WLaney/L3GD20H-gyro-PCB/gyro.brd

## EAGLE design gyro.brd (2016-07-08)

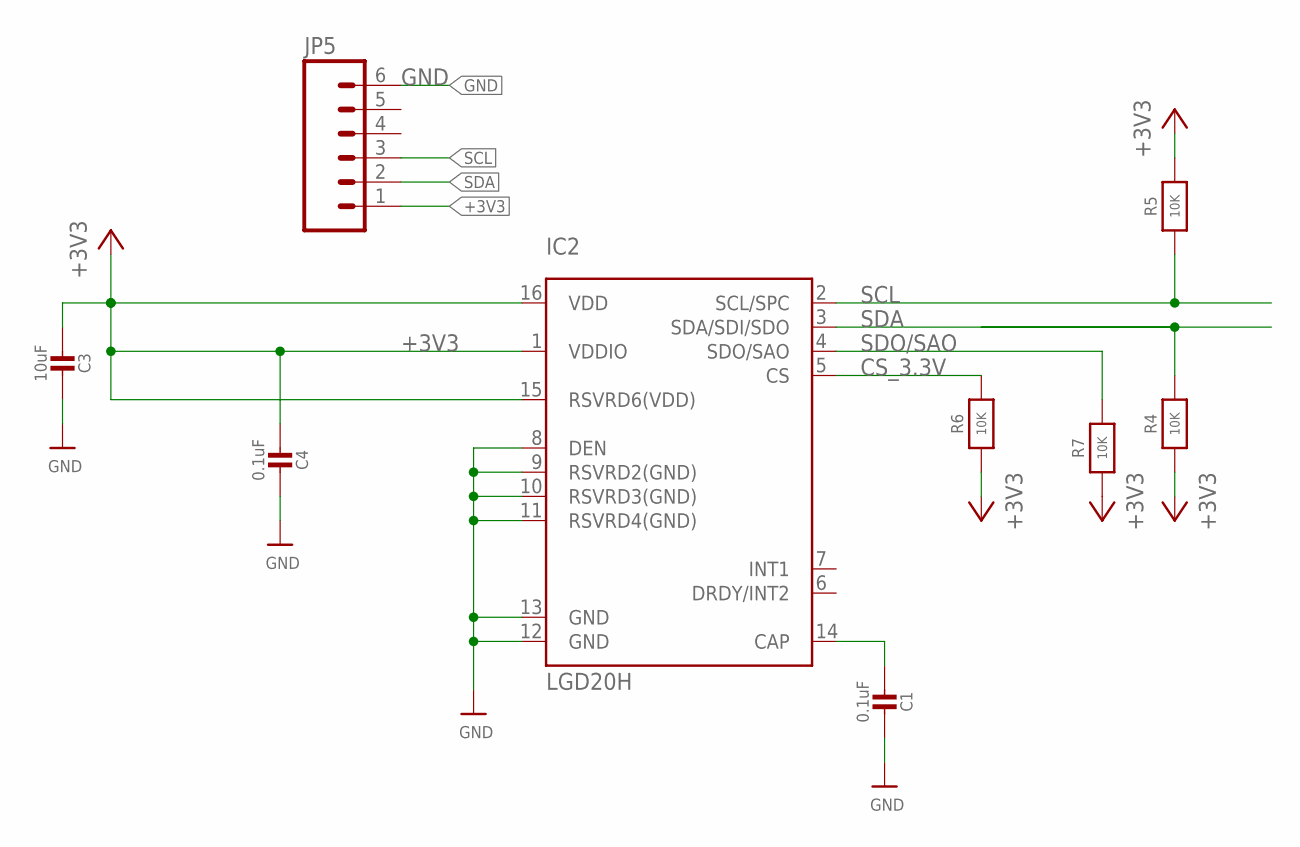
[picture p1: schematic gyro.sch]

Parts:
C1, C4: 0.1uF; 0805-NO
C3: 10uF; 0805-NO
IC2: LGD20H; L3GD20H_LGA16L
JP5: M06SIP; 1X06
R4, R5, R7: 10K; 0805-NO
R6: 10K; _0805MP

Connections:
+3V3: C3.2, C4.2, IC2.1 (VDDIO), IC2.15 (RSVRD6(VDD)), IC2.16 (VDD), JP5.1, R4.1, R5.2, R6.1, R7.1
CS_3.3V: IC2.5 (CS), R6.2
GND: C1.1, C3.1, C4.1, IC2.8 (DEN), IC2.9 (RSVRD2(GND)), IC2.10 (RSVRD3(GND)), IC2.11 (RSVRD4(GND)), IC2.12 (GND), IC2.13 (GND), JP5.6
unnamed: C1.2, IC2.14 (CAP)
SCL: IC2.2 (SCL/SPC), JP5.3, R5.1
SDA: IC2.3 (SDA/SDI/SDO), JP5.2, R4.2
SDO/SAO: IC2.4 (SDO/SAO), R7.2

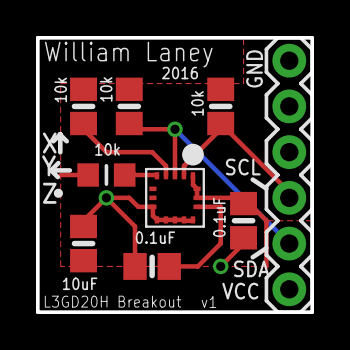
[picture p2: board gyro.brd from above]

Board: 2 copper layers, 15.2 x 15.2 mm, 9 parts (0 on the bottom side), 7 nets.
