WLaney/L3GD20H-gyro-PCB/(commit log)

2016-06-15 created layout for just the gyro
    [gyro.brd, gyro.sch]
2016-06-15 boards rounted with silk screen
    [gyro.brd, gyro.sch]
2016-06-15 shortedn connections, removed via
    [gyro.brd, gyro.sch]
2016-06-15 rottated header 180 degrees
    [gyro.brd]
2016-06-15 added six pin header to stack with accell
    [gyro.brd, gyro.sch]
2016-06-15 set up pins to line up with accel corectly
    [gyro.brd, gyro.sch]
2016-06-15 minor placment adjustments
    [gyro.brd]
2016-06-16 final touches
    [gyro.brd]
2016-06-16 final verson to submit to osh park for protyping
    [gyro.brd]
2016-06-16 adjusted tname and tvalue layers
    [gyro.brd]
2016-06-17 adjusted silk screen layout
    [gyro.brd]
2016-06-30 added bom
2016-07-08 who knows, probably just opened the file
    [gyro.brd]
2016-07-15 Proofread gyroscope/documentation.txt
    Grammar, spelling updates. Clarified nature of axis/rotation labels.
2016-11-29 added package sizes to BOM
    IC size was formely NA now it has the package type of the IC
